reykato/lightwear/pcb/bracelet/lightwear_bracelet_btn_fpc/lightwear_bracelet_btn_fpc.kicad_pcb

## KiCad design pcb/bracelet/lightwear_bracelet_btn_fpc/lightwear_bracelet_btn_fpc.kicad_pcb (2026-06-30)

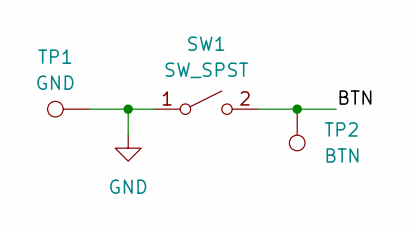
[picture p1: schematic lightwear_bracelet_btn_fpc.kicad_sch]

Parts:
SW1: SW_SPST; GT-TC155X-HXXXX-LX
TP1: GND; TestPoint_Pad_1.5x0.8mm_slim
TP2: BTN; TestPoint_Pad_1.5x0.8mm_slim

Connections:
/BTN: SW1.2 (B), TP2.1
GND: SW1.1 (A), TP1.1

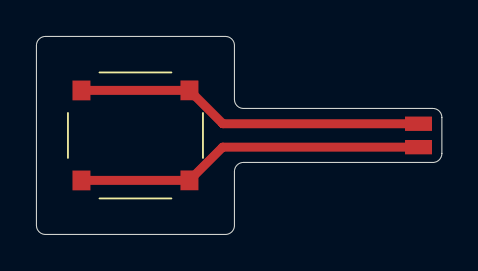
[picture p2: board lightwear_bracelet_btn_fpc.kicad_pcb from above]

Board: 2 copper layers, 22.5 x 11.0 mm, 3 parts (0 on the bottom side), 2 nets.
