reykato/lightwear/pcb/bracelet/lightwear_bracelet_20x15_audio_reactive/lightwear_bracelet_20x15_audio_reactive.kicad_pcb

## KiCad design pcb/bracelet/lightwear_bracelet_20x15_audio_reactive/lightwear_bracelet_20x15_audio_reactive.kicad_pcb (2026-06-30)

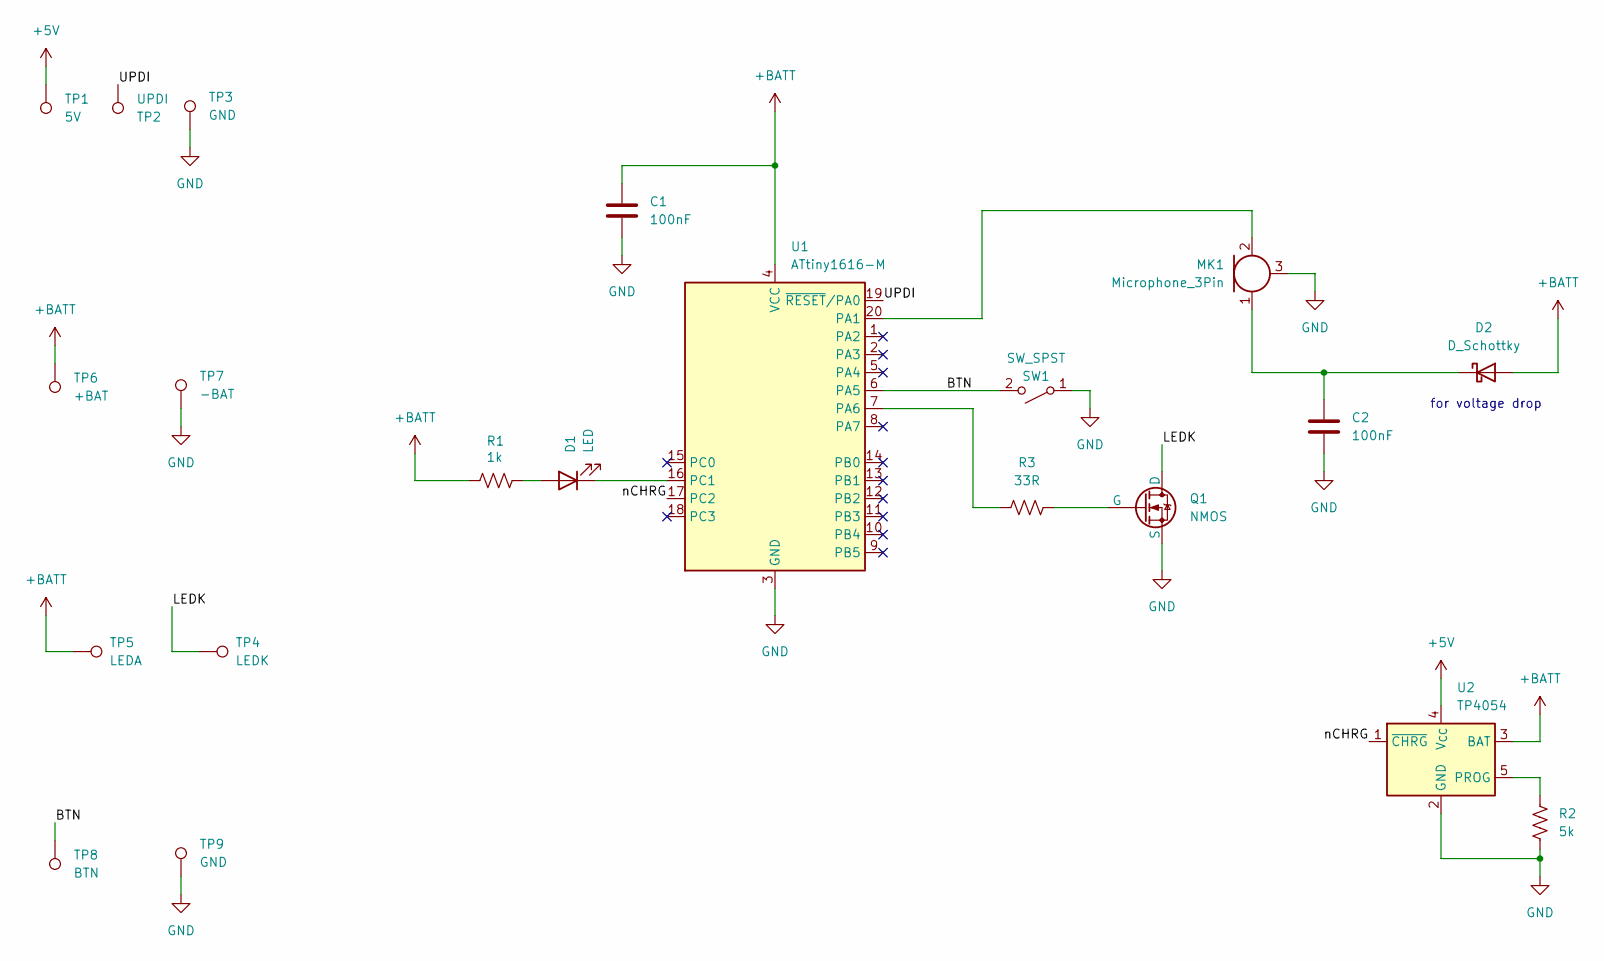
[picture p3: schematic lightwear_bracelet_20x15_audio_reactive.kicad_sch]

Parts:
C1, C2: 100nF; C_0402_1005Metric
D1: LED; LED_0603_1608Metric
D2: D_Schottky; SOT-23
MK1: Microphone_3Pin; MSM381ACB026
Q1: NMOS; SOT-23-MOSFET
R1: 1k; R_0402_1005Metric
R2: 5k; R_0402_1005Metric
R3: 33R; R_0402_1005Metric
SW1: SW_SPST; SW4_PTS815 SJM 250 SMTR LFS_CNK
TP1: 5V; TestPoint_Pad_D1.5mm
TP2: UPDI; TestPoint_Pad_D1.5mm
TP3: GND; TestPoint_Pad_D1.5mm
TP4: LEDK; TestPoint_Pad_2.0x1.2mm_slim
TP5: LEDA; TestPoint_Pad_2.0x1.2mm_slim
TP6: +BAT; TestPoint_Pad_Triangle
TP7: -BAT; TestPoint_Pad_Triangle
TP8: BTN; TestPoint_Pad_1.5x0.8mm_slim
TP9: GND; TestPoint_Pad_1.5x0.8mm_slim
U1: ATtiny1616-M; VQFN-20-1EP_3x3mm_P0.4mm_EP1.7x1.7mm
U2: TP4054; TSOT-23-5

Connections:
+5V: TP1.1, U2.4 (V_{CC})
+BATT: C1.1, D2.2 (A), R1.1, TP5.1, TP6.1, U1.4 (VCC), U2.3 (BAT)
/BTN: SW1.2 (B), TP8.1, U1.6 (PA5)
/LEDK: Q1.1 (D), TP4.1
/UPDI: TP2.1, U1.19 (~RESET/PA0)
/nCHRG: U1.17 (PC2), U2.1 (~CHRG)
GND: C1.2, C2.1, MK1.3 (GND), Q1.3 (S), R2.2, SW1.1 (A), TP3.1, TP7.1, TP9.1, U1.3 (GND), U1.21 (GND), U2.2 (GND)
unnamed: D1.2 (A), R1.2
unnamed: D1.1 (K), U1.16 (PC1)
unnamed: C2.2, D2.1 (K), MK1.1 (VDD)
unnamed: MK1.2 (OUT), U1.20 (PA1)
unnamed: Q1.2 (G), R3.2
unnamed: R3.1, U1.7 (PA6)
unnamed: R2.1, U2.5 (PROG)

Notes on the sheet:
for voltage drop

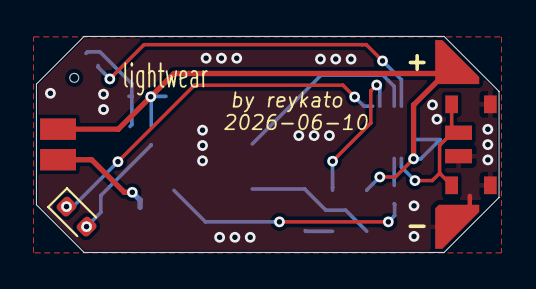
[picture p4: board lightwear_bracelet_20x15_audio_reactive.kicad_pcb from above]

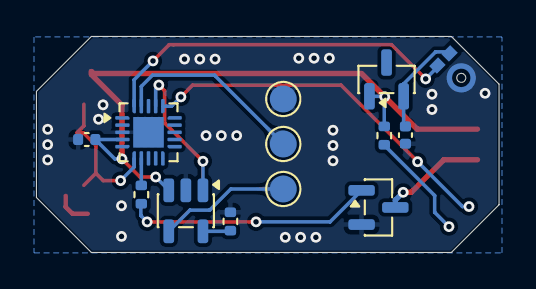
[picture p5: board lightwear_bracelet_20x15_audio_reactive.kicad_pcb from below]

Board: 2 copper layers, 25.7 x 12.0 mm, 21 parts (13 on the bottom side), 14 nets.
