reykato/lightwear/pcb/bracelet/lightwear_bracelet_12x15_bat/lightwear_bracelet_12x15_bat.kicad_pcb

## KiCad design pcb/bracelet/lightwear_bracelet_12x15_bat/lightwear_bracelet_12x15_bat.kicad_pcb (2026-06-03)

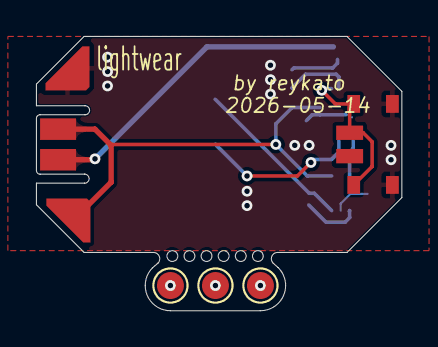
[picture p6: board lightwear_bracelet_12x15_bat.kicad_pcb from above]

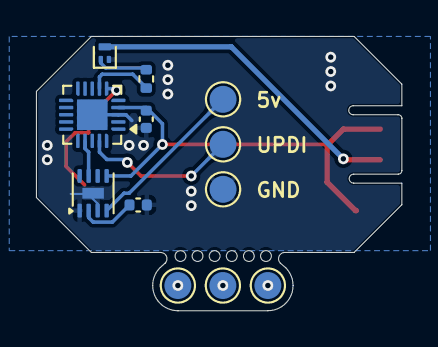
[picture p7: board lightwear_bracelet_12x15_bat.kicad_pcb from below]

Board: 2 copper layers, 20.3 x 15.2 mm, 22 parts (12 on the bottom side), 13 nets.

Parts:
C1: 100nF; C_0402_1005Metric
Q1: NMOS; SOT-883
R2: 22k; C_0402_1005Metric
R3: 33R; R_0402_1005Metric
SW1: SW_SPST; SW4_PTS815 SJM 250 SMTR LFS_CNK
TP1, TP2, TP3, TP4#2, TP5#2, TP6#2: TestPoint; TestPoint_Pad_D1.5mm
TP1#2: 5V; TestPoint_Pad_D1.5mm
TP2#2: UPDI; TestPoint_Pad_D1.5mm
TP3#2: GND; TestPoint_Pad_D1.5mm
TP4: LEDK; TestPoint_Pad_2.0x1.2mm_slim
TP5: LEDA; TestPoint_Pad_2.0x1.2mm_slim
TP6: +BAT; TestPoint_Pad_Triangle
TP7: -BAT; TestPoint_Pad_Triangle
TP8: BTN; TestPoint_Pad_1.5x0.8mm_slim
TP9: GND; TestPoint_Pad_1.5x0.8mm_slim
U1: ATtiny1616-M; VQFN-20-1EP_3x3mm_P0.4mm_EP1.7x1.7mm
U2: WB6058D; DFN-8-1EP_2x2mm_P0.5mm_EP0.6x1.2mm

Connections:
+5V: TP1#2.1, U2.4 (V_{CC})
+BATT: C1.1, TP5.1, TP6.1, U1.4 (VCC), U2.5 (BAT)
/BTN: SW1.2 (B), TP8.1, U1.6 (PA5)
/LEDK: Q1.3 (D), TP4.1
/UPDI: TP2#2.1, U1.19 (~RESET/PA0)
/nCHRG: U1.17 (PC2), U2.7 (~CHRG)
GND: C1.2, Q1.2 (S), R2.1, SW1.1 (A), TP3#2.1, TP7.1, TP9.1, U1.3 (GND), U1.21 (GND), U2.1 (TEMP), U2.3 (GND), U2.9 (BASE)
unnamed: Q1.1 (G), R3.2
unnamed: TP1.1, TP6#2.1
unnamed: TP2.1, TP5#2.1
unnamed: TP3.1, TP4#2.1
unnamed: R3.1, U1.7 (PA6)
unnamed: R2.2, U2.2 (ISET)
