reykato/lightwear/pcb/necklace/lightwear_mainboard/lightwear.kicad_pcb

## KiCad design pcb/necklace/lightwear_mainboard/lightwear.kicad_pcb (2026-05-07)

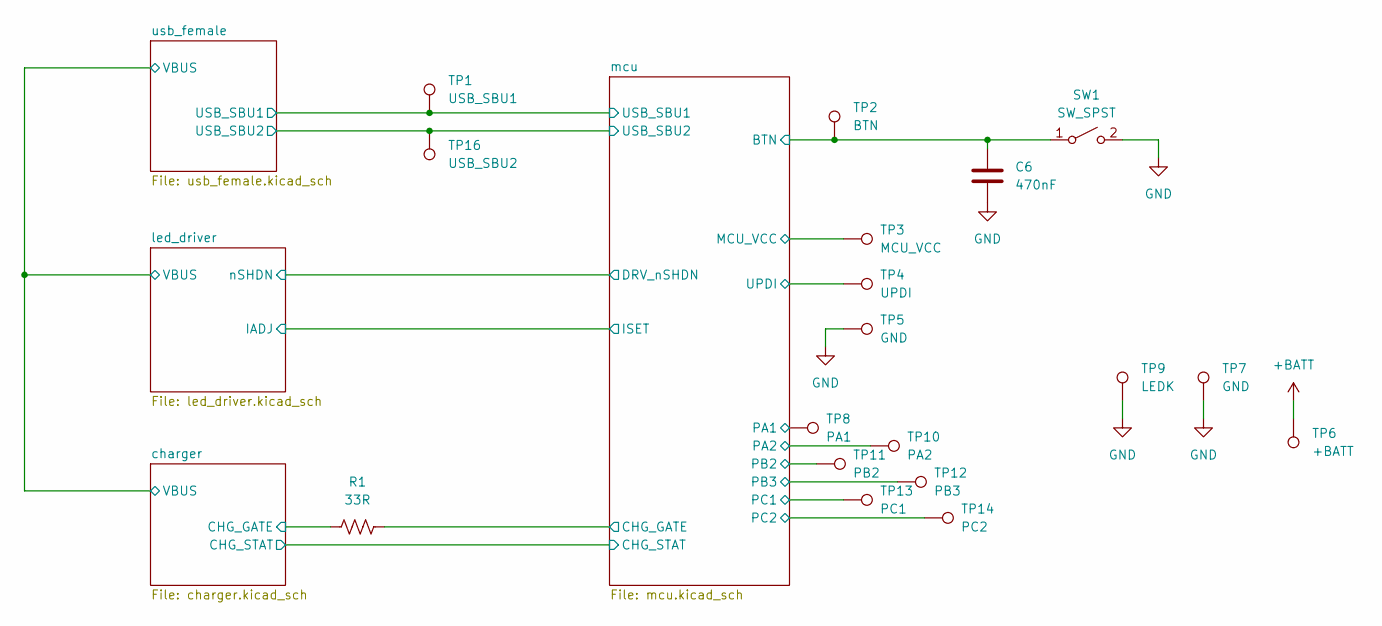
[picture p8: schematic lightwear.kicad_sch]

Parts:
C6: 470nF; C_0402_1005Metric
R1: 33R; R_0402_1005Metric
SW1: SW_SPST; SW4_PTS815 SJM 250 SMTR LFS_CNK
TP1: USB_SBU1; TestPoint_Pad_D2.0mm
TP2: BTN; TestPoint_Pad_D2.0mm
TP3: MCU_VCC; TestPoint_Pad_D1.5mm
TP4: UPDI; TestPoint_Pad_D1.5mm
TP5: GND; TestPoint_Pad_D1.5mm
TP6: +BATT; TestPoint_Pad_1.5x1.5mm
TP7: GND; TestPoint_Pad_1.5x1.5mm
TP8: PA1; TestPoint_Pad_D2.0mm
TP9: LEDK; TestPoint_Pad_6.0x12.0mm
TP10: PA2; TestPoint_Pad_D2.0mm
TP11: PB2; TestPoint_Pad_D2.0mm
TP12: PB3; TestPoint_Pad_D2.0mm
TP13: PC1; TestPoint_Pad_D2.0mm
TP14: PC2; TestPoint_Pad_D2.0mm
TP16: USB_SBU2; TestPoint_Pad_D2.0mm

Connections:
+BATT: TP6.1; also elsewhere on the board
/charger/CHG_GATE: R1.2; also elsewhere on the board
/mcu/BTN: C6.1, SW1.1 (A), TP2.1; also elsewhere on the board
/mcu/CHG_GATE: R1.1; also elsewhere on the board
/mcu/MCU_VCC: TP3.1; also elsewhere on the board
/mcu/PA1: TP8.1; also elsewhere on the board
/mcu/PA2: TP10.1; also elsewhere on the board
/mcu/PB2: TP11.1; also elsewhere on the board
/mcu/PB3: TP12.1; also elsewhere on the board
/mcu/PC1: TP13.1; also elsewhere on the board
/mcu/PC2: TP14.1; also elsewhere on the board
/mcu/UPDI: TP4.1; also elsewhere on the board
/mcu/USB_SBU1: TP1.1; also elsewhere on the board
/mcu/USB_SBU2: TP16.1; also elsewhere on the board
GND: C6.2, SW1.2 (B), TP5.1, TP7.1, TP9.1; also elsewhere on the board

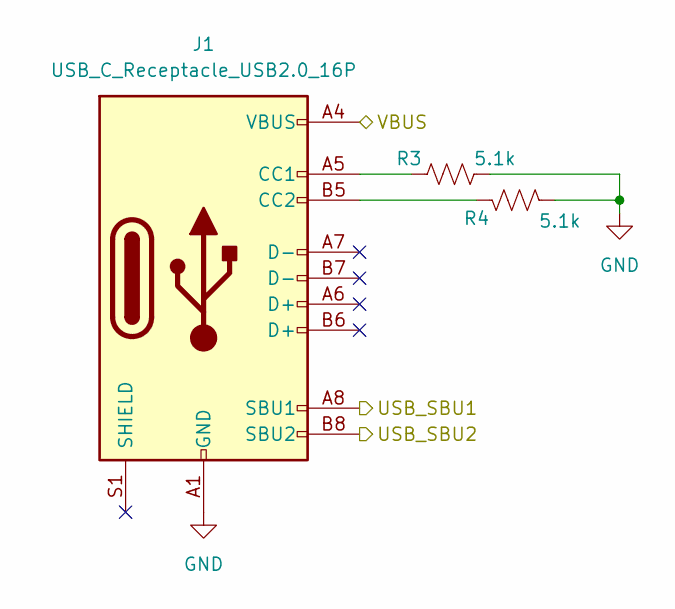
[picture p9: schematic usb_female.kicad_sch]

Parts:
J1: USB_C_Receptacle_USB2.0_16P; USB_C_Receptacle_G-Switch_GT-USB-7010ASV
R3, R4: 5.1k; R_0402_1005Metric

Connections:
/charger/VBUS: J1.A4 (VBUS), J1.A9 (VBUS), J1.B4 (VBUS), J1.B9 (VBUS); also elsewhere on the board
/mcu/USB_SBU1: J1.A8 (SBU1); also elsewhere on the board
/mcu/USB_SBU2: J1.B8 (SBU2); also elsewhere on the board
GND: J1.A1 (GND), J1.A12 (GND), J1.B1 (GND), J1.B12 (GND), R3.2, R4.2; also elsewhere on the board
unnamed: J1.A5 (CC1), R3.1
unnamed: J1.B5 (CC2), R4.1

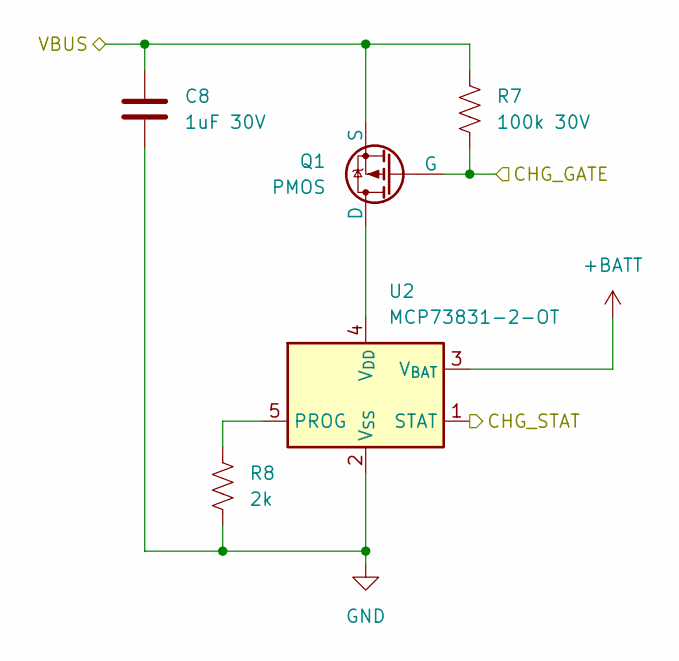
[picture p10: schematic charger.kicad_sch]

Parts:
C8: 1uF 30V; C_0402_1005Metric
Q1: PMOS; SOT-23-3
R7: 100k 30V; R_0402_1005Metric
R8: 2k; R_0402_1005Metric
U2: MCP73831-2-OT; SOT-23-5

Connections:
+BATT: U2.3 (V_{BAT}); also elsewhere on the board
/charger/CHG_GATE: Q1.2 (G), R7.1; also elsewhere on the board
/charger/CHG_STAT: U2.1 (STAT); also elsewhere on the board
/charger/VBUS: C8.1, Q1.3 (S), R7.2; also elsewhere on the board
GND: C8.2, R8.1, U2.2 (V_{SS}); also elsewhere on the board
unnamed: Q1.1 (D), U2.4 (V_{DD})
unnamed: R8.2, U2.5 (PROG)

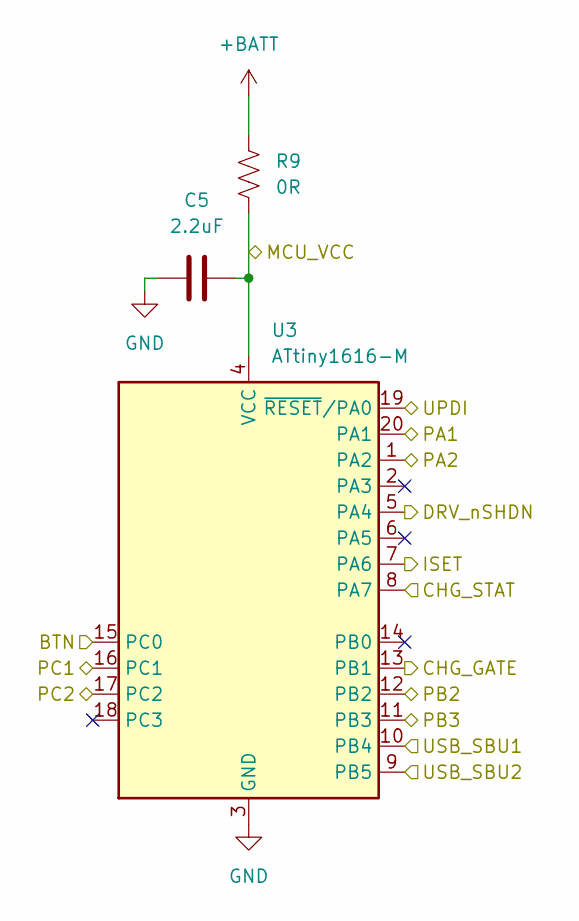
[picture p11: schematic mcu.kicad_sch]

Parts:
C5: 2.2uF; C_0402_1005Metric
R9: 0R; R_0402_1005Metric
U3: ATtiny1616-M; VQFN-20-1EP_3x3mm_P0.4mm_EP1.7x1.7mm

Connections:
+BATT: R9.1; also elsewhere on the board
/charger/CHG_STAT: U3.8 (PA7); also elsewhere on the board
/led_driver/IADJ: U3.7 (PA6); also elsewhere on the board
/led_driver/nSHDN: U3.5 (PA4); also elsewhere on the board
/mcu/BTN: U3.15 (PC0); also elsewhere on the board
/mcu/CHG_GATE: U3.13 (PB1); also elsewhere on the board
/mcu/MCU_VCC: C5.2, R9.2, U3.4 (VCC); also elsewhere on the board
/mcu/PA1: U3.20 (PA1); also elsewhere on the board
/mcu/PA2: U3.1 (PA2); also elsewhere on the board
/mcu/PB2: U3.12 (PB2); also elsewhere on the board
/mcu/PB3: U3.11 (PB3); also elsewhere on the board
/mcu/PC1: U3.16 (PC1); also elsewhere on the board
/mcu/PC2: U3.17 (PC2); also elsewhere on the board
/mcu/UPDI: U3.19 (~RESET/PA0); also elsewhere on the board
/mcu/USB_SBU1: U3.10 (PB4); also elsewhere on the board
/mcu/USB_SBU2: U3.9 (PB5); also elsewhere on the board
GND: C5.1, U3.3 (GND), U3.21 (GND); also elsewhere on the board

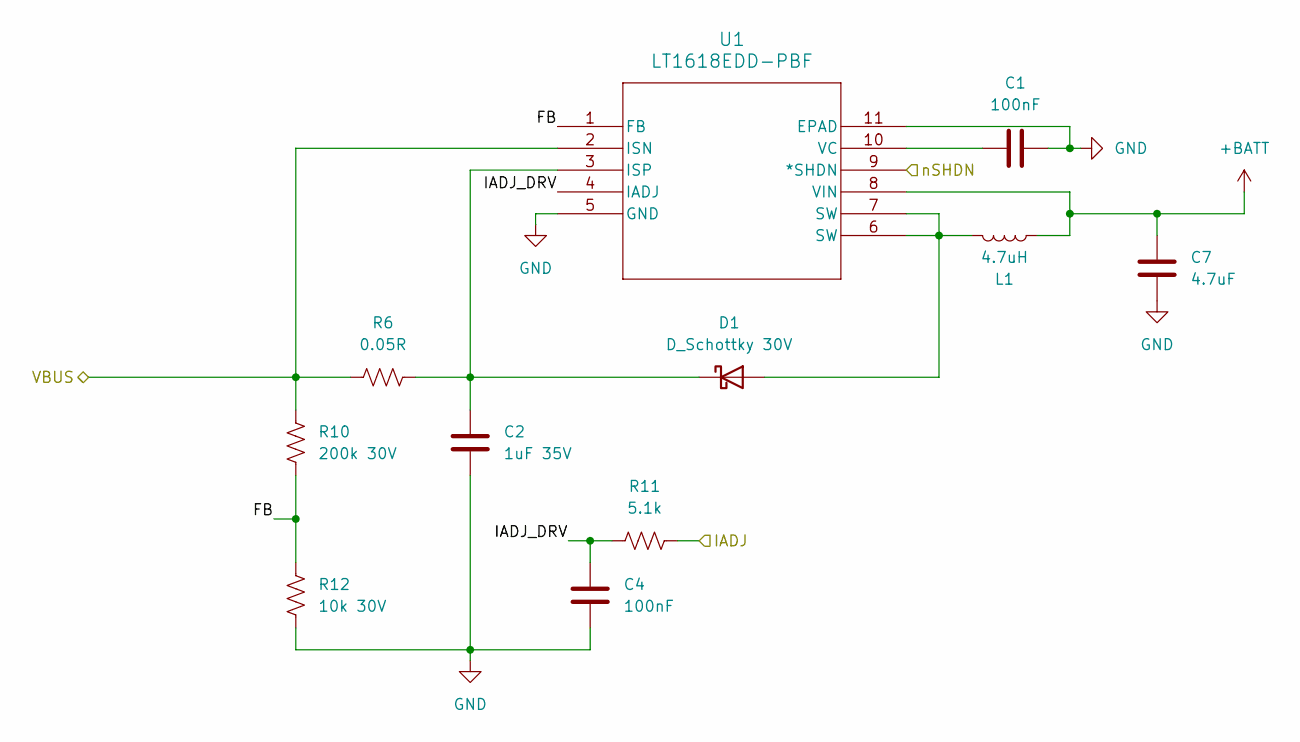
[picture p12: schematic led_driver.kicad_sch]

Parts:
C1, C4: 100nF; C_0402_1005Metric
C2: 1uF 35V; C_0603_1608Metric
C7: 4.7uF; C_0402_1005Metric
D1: D_Schottky 30V; D_SOD-123
L1: 4.7uH; L_Changjiang_FNR4030S
R6: 0.05R; R_1206_3216Metric
R10: 200k 30V; R_0402_1005Metric
R11: 5.1k; R_0402_1005Metric
R12: 10k 30V; R_0402_1005Metric
U1: LT1618EDD-PBF; DFN-10_DD_LIT

Connections:
+BATT: C7.1, L1.2, U1.8 (VIN); also elsewhere on the board
/charger/VBUS: R6.2, R10.2, U1.2 (ISN); also elsewhere on the board
/led_driver/FB: R10.1, R12.2, U1.1 (FB)
/led_driver/IADJ: R11.1; also elsewhere on the board
/led_driver/IADJ_DRV: C4.1, R11.2, U1.4 (IADJ)
/led_driver/nSHDN: U1.9 (*SHDN); also elsewhere on the board
GND: C1.2, C2.2, C4.2, C7.2, R12.1, U1.5 (GND), U1.11 (EPAD); also elsewhere on the board
unnamed: D1.2 (A), L1.1, U1.6 (SW), U1.7 (SW)
unnamed: C2.1, D1.1 (K), R6.1, U1.3 (ISP)
unnamed: C1.1, U1.10 (VC)

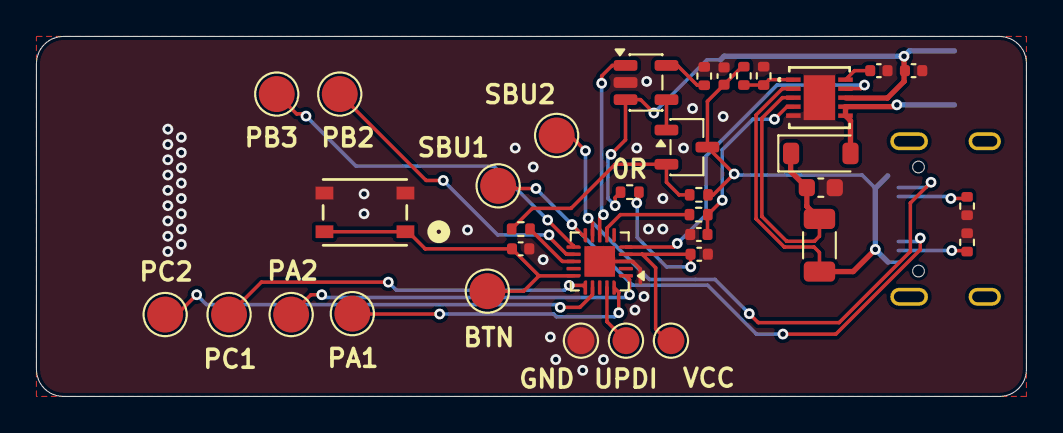
[picture p13: board lightwear.kicad_pcb from above]

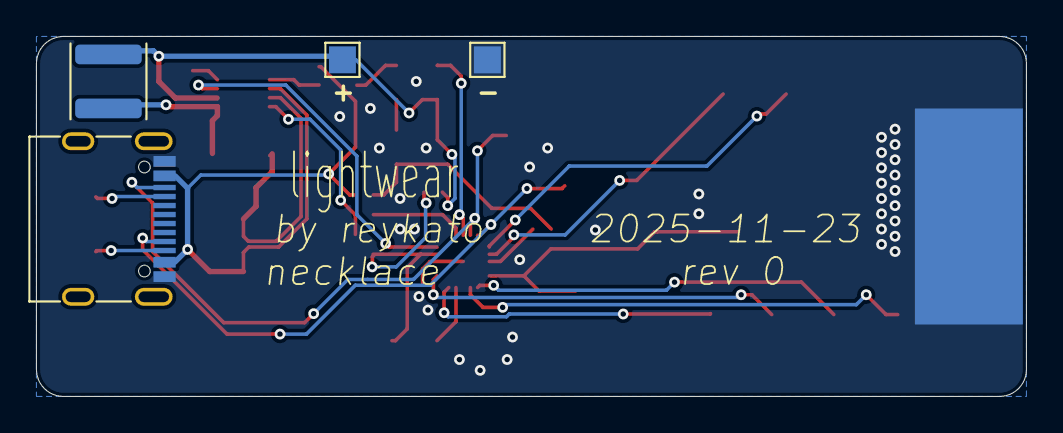
[picture p14: board lightwear.kicad_pcb from below]

Board: 2 copper layers, 55.0 x 20.0 mm, 40 parts (5 on the bottom side), 28 nets.
