reykato/lightwear/pcb/necklace/lightwear_clasp/lightwear_clasp.kicad_pcb

## KiCad design pcb/necklace/lightwear_clasp/lightwear_clasp.kicad_pcb (2026-05-07)

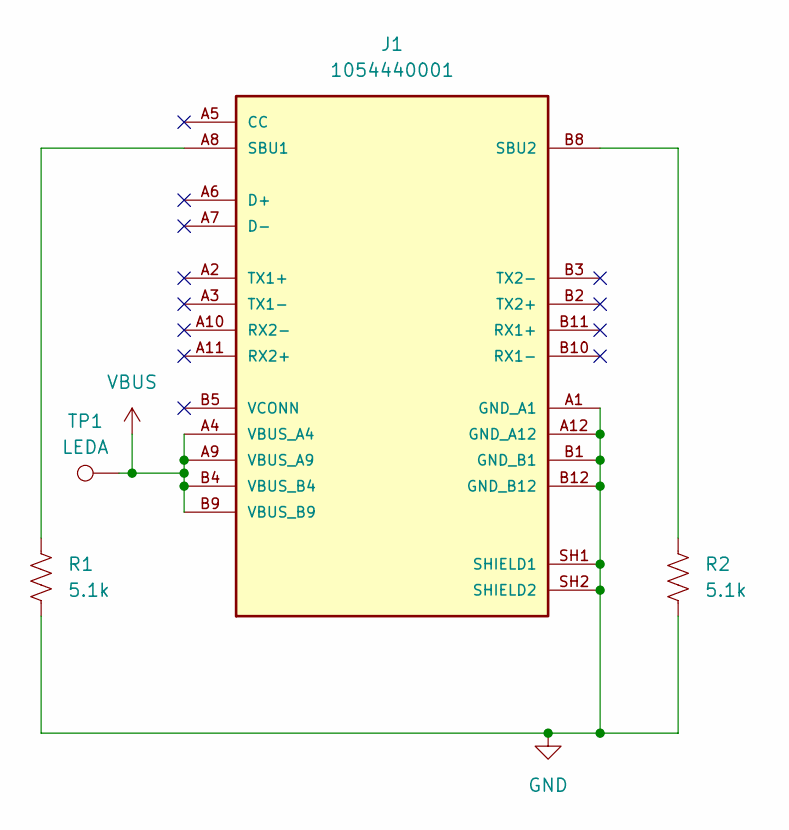
[picture p15: schematic lightwear_clasp.kicad_sch]

Parts:
J1: 1054440001; MOLEX_1054440001; PARTREV C2
R1, R2: 5.1k; R_0402_1005Metric
TP1: LEDA; TestPoint_Pad_6.0x8.2mm

Connections:
GND: J1.A1 (GND_A1), J1.A12 (GND_A12), J1.B1 (GND_B1), J1.B12 (GND_B12), J1.SH1 (SHIELD1), J1.SH2 (SHIELD2), R1.2, R2.2
unnamed: J1.A8 (SBU1), R1.1
unnamed: J1.B8 (SBU2), R2.1
VBUS: J1.A4 (VBUS_A4), J1.A9 (VBUS_A9), J1.B4 (VBUS_B4), J1.B9 (VBUS_B9), TP1.1

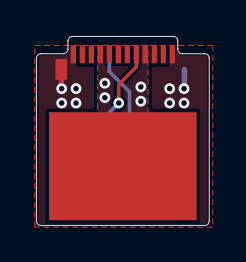
[picture p16: board lightwear_clasp.kicad_pcb from above]

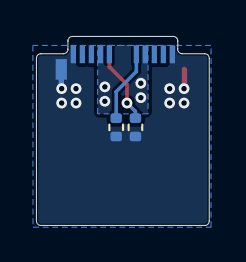
[picture p17: board lightwear_clasp.kicad_pcb from below]

Board: 2 copper layers, 9.6 x 10.5 mm, 4 parts (2 on the bottom side), 4 nets.
