reykato/lightwear/pcb/bracelet/lightwear_bracelet_12x15_bat_charging_stack/lightwear_bracelet_12x15_bat_charging_stack.kicad_pcb

## KiCad design pcb/bracelet/lightwear_bracelet_12x15_bat_charging_stack/lightwear_bracelet_12x15_bat_charging_stack.kicad_pcb (2026-05-07)

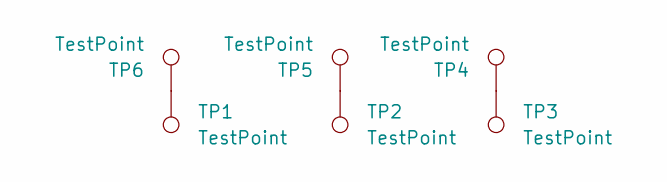
[picture p18: schematic lightwear_bracelet_12x15_bat_charging_stack.kicad_sch]

Parts:
TP1, TP2, TP3, TP4, TP5, TP6: TestPoint; TestPoint_Pad_D1.5mm

Connections:
unnamed: TP1.1, TP6.1
unnamed: TP2.1, TP5.1
unnamed: TP3.1, TP4.1

Board: 6 copper layers, 6 parts (3 on the bottom side), 3 nets, no tracks yet.
