reykato/lightwear/(commit log)

2025-11-24 rev0 done
    [charger.kicad_sch, led_driver.kicad_sch, lightwear.kicad_pcb, lightwear.kicad_sch, mcu.kicad_sch]
2025-11-24 small tweak
    [lightwear.kicad_pcb]
2025-11-24 finishing touches made, exported as rev0
    [lightwear-B_Cu.gbr, lightwear-B_Mask.gbr, lightwear-B_Paste.gbr, lightwear-B_Silkscreen.gbr, lightwear-Edge_Cuts.gbr, lightwear-F_Cu.gbr, lightwear-F_Mask.gbr, lightwear-F_Paste.gbr]
2025-11-24 added lightwear_clasp pcb, male usb-c
    [charger.kicad_sch, led_driver.kicad_sch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]
2025-11-24 generated gerbers
2025-11-24 updated 3d models
    [lightwear.kicad_pcb, lightwear_clasp.kicad_pcb]
2025-12-13 bracelet rev0 complete
    [lightwear-B_Cu.gbr, lightwear-B_Mask.gbr, lightwear-B_Paste.gbr, lightwear-B_Silkscreen.gbr, lightwear-Edge_Cuts.gbr, lightwear-F_Cu.gbr, lightwear-F_Mask.gbr, lightwear-F_Paste.gbr]
2025-12-14 rev0 of bracelet pcb finished and ordered
    [charger.kicad_sch, led_driver.kicad_sch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]
2026-01-01 change vref to 2.5v
2026-02-02 Started work on PCB without battery chips
    [lightwear_bracelet.kicad_pcb]
2026-02-11 15x20mm battery version done
    [lightwear_bracelet-B_Cu.gbr, lightwear_bracelet-B_Mask.gbr, lightwear_bracelet-B_Paste.gbr, lightwear_bracelet-B_Silkscreen.gbr, lightwear_bracelet-Edge_Cuts.gbr, lightwear_bracelet-F_Cu.gbr, lightwear_bracelet-F_Mask.gbr, lightwear_bracelet-F_Paste.gbr]
2026-02-15 changed battery connection to interface with bms board directly
    [charger.kicad_sch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]
2026-03-08 code for bracelet working. 4 brightness modes (including OFF) and battery checking (25% increments)
    [lightwear_bracelet.kicad_pcb, lightwear_bracelet.kicad_sch]
2026-03-09 fix ADC setup and battery measurement, improve showBatteryLevel with delays before and after showing battery level
    [main.cpp]
2026-03-31 refactor: improve power management and ADC configuration, enhance battery level indication
2026-03-31 docs: add detailed measurements and observations on power consumption and sleep mode performance
2026-04-15 12x15 bat finished
    [lightwear_bracelet_12x15_bat-B_Cu.gbr, lightwear_bracelet_12x15_bat-B_Mask.gbr, lightwear_bracelet_12x15_bat-B_Paste.gbr, lightwear_bracelet_12x15_bat-B_Silkscreen.gbr, lightwear_bracelet_12x15_bat-Edge_Cuts.gbr, lightwear_bracelet_12x15_bat-F_Cu.gbr, lightwear_bracelet_12x15_bat-F_Mask.gbr, lightwear_bracelet_12x15_bat-F_Paste.gbr]
2026-05-07 fix footprint for sot-883 mosfet, add pads for flex button board
    [lightwear_bracelet_12x15_bat-B_Cu.gbr, lightwear_bracelet_12x15_bat-B_Mask.gbr, lightwear_bracelet_12x15_bat-B_Paste.gbr, lightwear_bracelet_12x15_bat-B_Silkscreen.gbr, lightwear_bracelet_12x15_bat-Edge_Cuts.gbr, lightwear_bracelet_12x15_bat-F_Cu.gbr, lightwear_bracelet_12x15_bat-F_Mask.gbr, lightwear_bracelet_12x15_bat-F_Paste.gbr]
2026-06-03 12x15 bat PCB fixed with rev2 in code: removed references to onboard LED, restrict to only OFF, LOW, HIGH modes
    [lightwear_bracelet_12x15_bat-B_Cu.gbr, lightwear_bracelet_12x15_bat-B_Mask.gbr, lightwear_bracelet_12x15_bat-B_Paste.gbr, lightwear_bracelet_12x15_bat-B_Silkscreen.gbr, lightwear_bracelet_12x15_bat-Edge_Cuts.gbr, lightwear_bracelet_12x15_bat-F_Cu.gbr, lightwear_bracelet_12x15_bat-F_Mask.gbr, lightwear_bracelet_12x15_bat-F_Paste.gbr]
2026-06-30 20x15_audio_reactive rev0 done
    [lightwear_bracelet_20x15_audio_reactive-B_Cu.gbr, lightwear_bracelet_20x15_audio_reactive-B_Mask.gbr, lightwear_bracelet_20x15_audio_reactive-B_Paste.gbr, lightwear_bracelet_20x15_audio_reactive-B_Silkscreen.gbr, lightwear_bracelet_20x15_audio_reactive-Edge_Cuts.gbr, lightwear_bracelet_20x15_audio_reactive-F_Cu.gbr, lightwear_bracelet_20x15_audio_reactive-F_Mask.gbr, lightwear_bracelet_20x15_audi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]
2026-07-15 Add charging detection ISR, plays breathing effect when charging, resumes user mode when done
